srobo/kch-hw/case/case.png

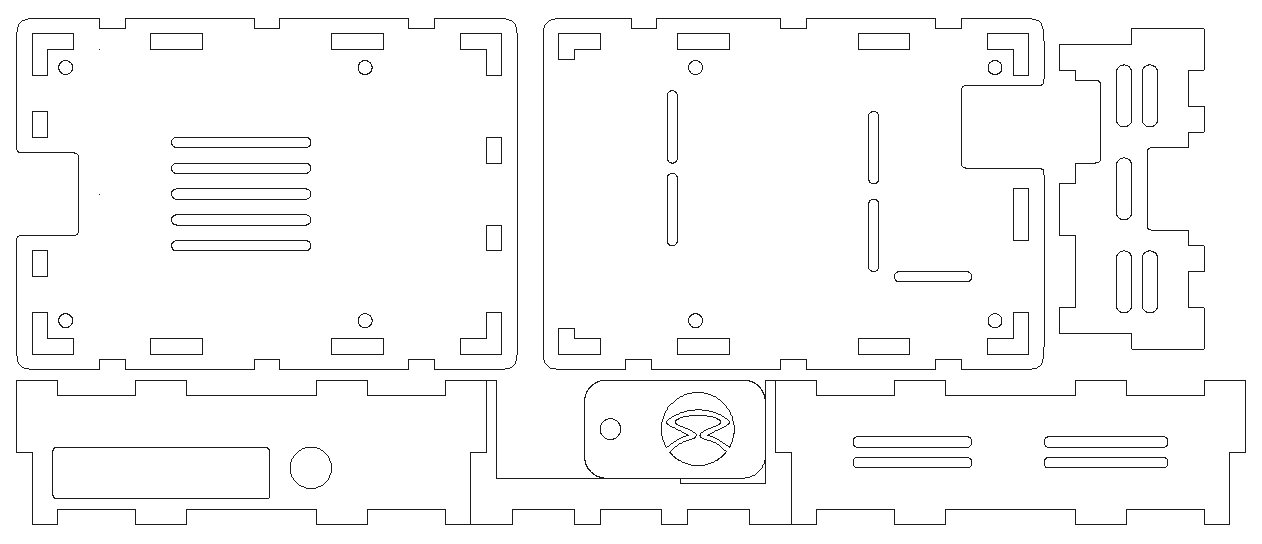
case/case.png
