srobo/kch-hw/case/case.dxf

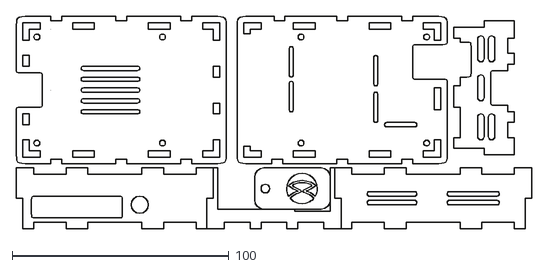
[picture p2: CAD file, 2022-09-02]
case/case.dxf
238.0 x 98.0
