srobo/kch-hw/pcb/3dmodels/camcon75.step

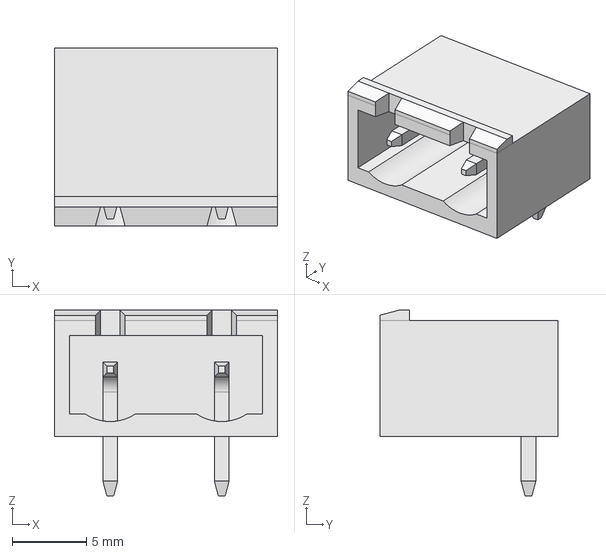
[picture p3: CAD file, 2022-07-02]
pcb/3dmodels/camcon75.step
15.0 x 12.0 x 12.5 mm
