srobo/kch-hw/pcb/3dmodels/FM-B2020.step

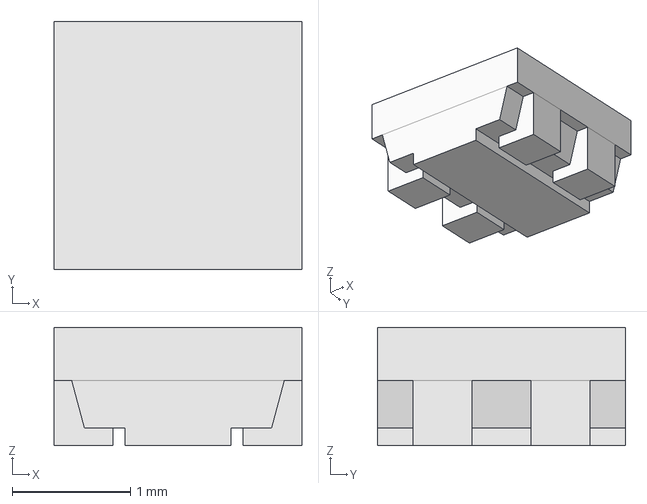
[picture p4: CAD file, 2022-07-02]
pcb/3dmodels/FM-B2020.step
2.10 x 2.10 x 1.00 mm
