srobo/kch-hw/pcb/3dmodels/mwsa0603.step

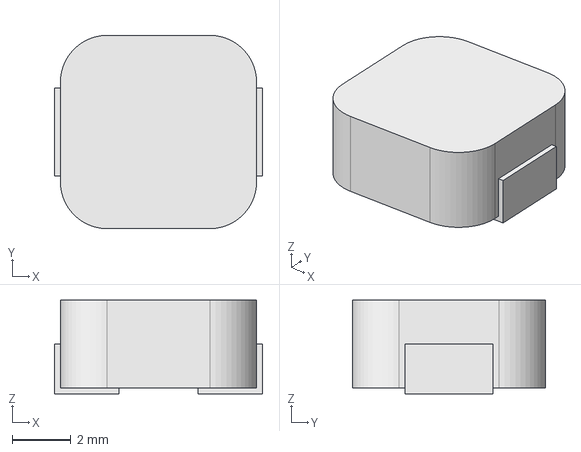
[picture p5: CAD file, 2022-07-02]
pcb/3dmodels/mwsa0603.step
7.10 x 6.60 x 3.20 mm
