srobo/kch-hw/(commit log)

2022-05-08 Initial schematic
    [KCH.kicad_pcb, KCH.kicad_sch, led.kicad_sch, power.kicad_sch, rgb_led.kicad_sch]
2022-05-09 More refinement
    [KCH.kicad_sch, led.kicad_sch, power.kicad_sch, rgb_led.kicad_sch]
2022-05-09 Schematic revision S1
    [KCH.kicad_sch, led.kicad_sch, power.kicad_sch, rgb_led.kicad_sch]
2022-05-14 Pre-review improvements
    [KCH.kicad_pcb, KCH.kicad_sch, led.kicad_sch, power.kicad_sch, rgb_led.kicad_sch]
2022-05-16 Add remaining footprints
    [KCH.kicad_pcb, KCH.kicad_sch, power.kicad_sch, rgb_led.kicad_sch]
2022-05-17 Updates for version S2
    [KCH.kicad_pcb, KCH.kicad_sch, led.kicad_sch, power.kicad_sch, rgb_led.kicad_sch]
2022-05-17 Standardise resistors to 0402
    [KCH.kicad_pcb, KCH.kicad_sch, led.kicad_sch, power.kicad_sch]
2022-07-02 V1 of the layout
    In line with spec.md and subject to review.
    [FM-B2020.step, KCH.kicad_pcb, KCH.kicad_sch, camcon75.step, led.kicad_sch, mwsa0603.step, power.kicad_sch, rgb_led.kicad_sch]
2022-07-02 Fixes in line with first review
    https://docs.google.com/document/d/1PPsveN5AECmyqWPPeilAtW6h0f65iSpew2GU25VMRJI/edit?usp=sharing
    (Thanks Josh for the notes)
    [KCH.kicad_pcb, KCH.kicad_sch, power.kicad_sch]
2022-07-02 First round of changes per layout review
    [KCH.kicad_pcb]
2022-07-02 LOGO + bee + tidy up
    [KCH.kicad_pcb]
2022-07-02 Set remaining JLC parts
    [KCH.kicad_pcb, rotations.csv]
2022-07-02 Fix board outline, remove silkscreen board overhang
    [KCH.kicad_pcb]
2022-07-02 Move camcon designator inside the board outline
    [KCH.kicad_pcb]
2022-07-02 Final prototype updates
    [KCH.kicad_pcb, rotations.csv]
2022-07-02 Add config for creating panel
    [KCH.kicad_sch, led.kicad_sch, power.kicad_sch, rgb_led.kicad_sch]
2022-07-02 Reorganise repo
    [FM-B2020.step, KCH.kicad_pcb, KCH.kicad_sch, camcon75.step, led.kicad_sch, mwsa0603.step, power.kicad_sch, rgb_led.kicad_sch]
2022-07-02 Fix fab layer
    [KCH.kicad_pcb]
2022-07-04 Update device tree and instructions
2022-07-16 Basic value changes
    [KCH.kicad_pcb, KCH.kicad_sch, led.kicad_sch, power.kicad_sch, rgb_led.kicad_sch]
2022-07-16 Update regulator to AP3200T
    [KCH.kicad_sch, led.kicad_sch, power.kicad_sch, rgb_led.kicad_sch]
2022-07-16 Updated regulator layout
    [KCH.kicad_pcb, KCH.kicad_sch, led.kicad_sch, power.kicad_sch, rgb_led.kicad_sch]
2022-07-16 Set JLCPCB parts
    [KCH.kicad_pcb, KCH.kicad_sch, led.kicad_sch, power.kicad_sch, rgb_led.kicad_sch]
2022-07-16 Fix kicad weirdnes
    [KCH.kicad_pcb]
2022-07-16 Update version
    [KCH.kicad_pcb, KCH.kicad_sch, led.kicad_sch, power.kicad_sch, rgb_led.kicad_sch]
2022-07-16 Correct regulator name
    [KCH.kicad_pcb, KCH.kicad_sch, led.kicad_sch, power.kicad_sch, rgb_led.kicad_sch]
2022-09-02 First parse case design
    [case.dxf]
2022-09-02 Final case design
    [case.dxf]
